RobertoD91/esp32-joystick2trainer/hardware/kicad/j2t-module-drc-report.txt

** Drc report for out/j2t-module.kicad_pcb **
** Created on 2026-11-06 23:44:49 **

** Found 73 DRC violations **
[lib_footprint_issues]: The current configuration does not include the library ''.
    Local override; Severity: warning
    @(108.3300 mm, 146.5700 mm): Footprint R7
[lib_footprint_issues]: The current configuration does not include the library ''.
    Local override; Severity: warning
    @(104.6000 mm, 151.8000 mm): Footprint J3
[lib_footprint_issues]: The current configuration does not include the library ''.
    Local override; Severity: warning
    @(109.3200 mm, 140.2000 mm): Footprint Q5
[lib_footprint_issues]: The current configuration does not include the library ''.
    Local override; Severity: warning
    @(103.4000 mm, 132.4000 mm): Footprint SW2
[lib_footprint_issues]: The current configuration does not include the library ''.
    Local override; Severity: warning
    @(104.2700 mm, 141.6400 mm): Footprint D6
[lib_footprint_issues]: The current configuration does not include the library ''.
    Local override; Severity: warning
    @(109.5300 mm, 151.0700 mm): Footprint R17
[lib_footprint_issues]: The current configuration does not include the library ''.
    Local override; Severity: warning
    @(109.1000 mm, 136.7200 mm): Footprint C7
[lib_footprint_issues]: The current configuration does not include the library ''.
    Local override; Severity: warning
    @(118.2300 mm, 138.8900 mm): Footprint R13
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
    Rule: board setup constraints silk; Severity: warning
    @(121.0000 mm, 162.0000 mm): Line on Edge.Cuts
    @(104.5900 mm, 160.4400 mm): Line on F.Silkscreen
[silk_edge_clearance]: Silkscreen clipped by board edge
    Rule: board setup constraints silk; Severity: warning
    @(121.0000 mm, 162.0000 mm): Line on Edge.Cuts
    @(117.4100 mm, 163.1000 mm): Line on F.Silkscreen
[silk_edge_clearance]: Silkscreen clipped by board edge
    Rule: board setup constraints silk; Severity: warning
    @(101.0000 mm, 100.0000 mm): Line on Edge.Cuts
    @(118.3100 mm, 100.2200 mm): Line on F.Silkscreen
[silk_edge_clearance]: Silkscreen clipped by board edge
    Rule: board setup constraints silk; Severity: warning
    @(101.0000 mm, 100.0000 mm): Line on Edge.Cuts
    @(103.6900 mm, 99.7000 mm): Line on F.Silkscreen
[silk_edge_clearance]: Silkscreen clipped by board edge
    Rule: board setup constraints silk; Severity: warning
    @(100.0000 mm, 161.0000 mm): Line on Edge.Cuts
    @(101.7500 mm, 116.3500 mm): Line on F.Silkscreen
[silk_edge_clearance]: Silkscreen clipped by board edge
    Rule: board setup constraints silk; Severity: warning
    @(100.0000 mm, 161.0000 mm): Line on Edge.Cuts
    @(101.7500 mm, 125.7500 mm): Line on F.Silkscreen

** Found 0 unconnected pads **

** Found 0 Footprint errors **

** End of Report **
