RobertoD91/esp32-joystick2trainer/hardware/images/schematic.png

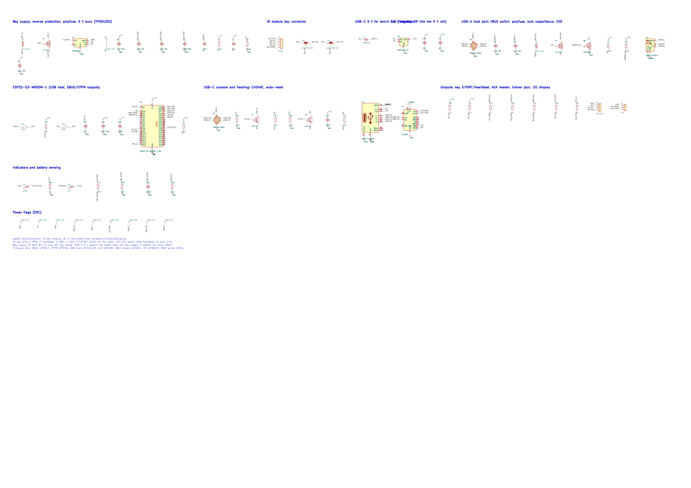
hardware/images/schematic.png
