RobertoD91/esp32-joystick2trainer/hardware/case/j2t-module-case-lite.stl

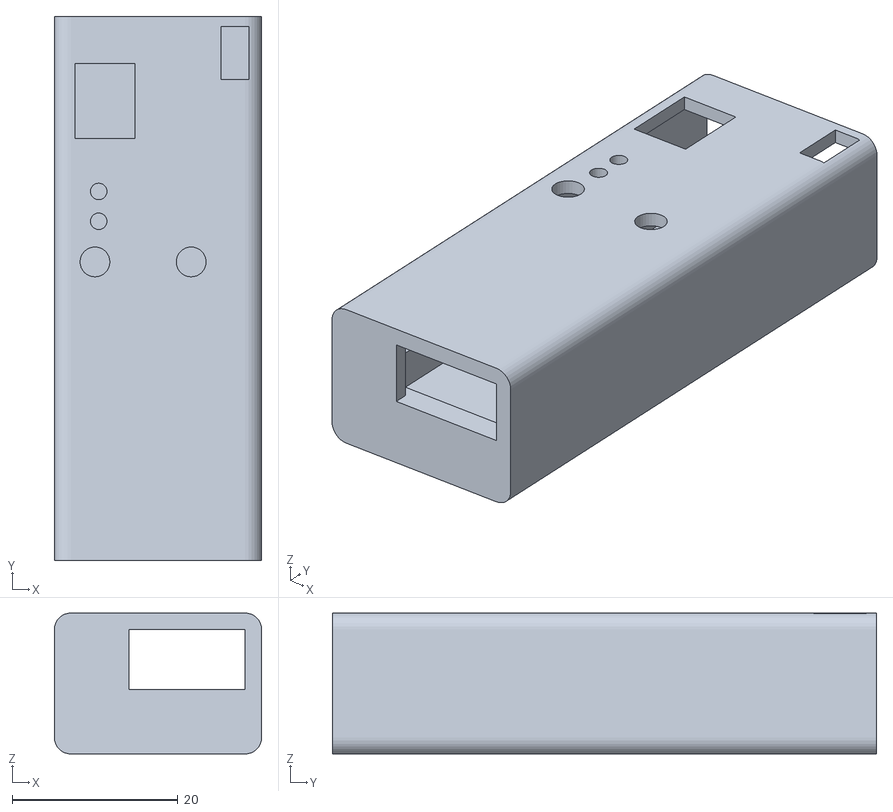
[picture p4: CAD file, 2026-11-06]
hardware/case/j2t-module-case-lite.stl
25.0 x 65.6 x 17.0
