RobertoD91/esp32-joystick2trainer/hardware/case/j2t-module-case-jr.stl

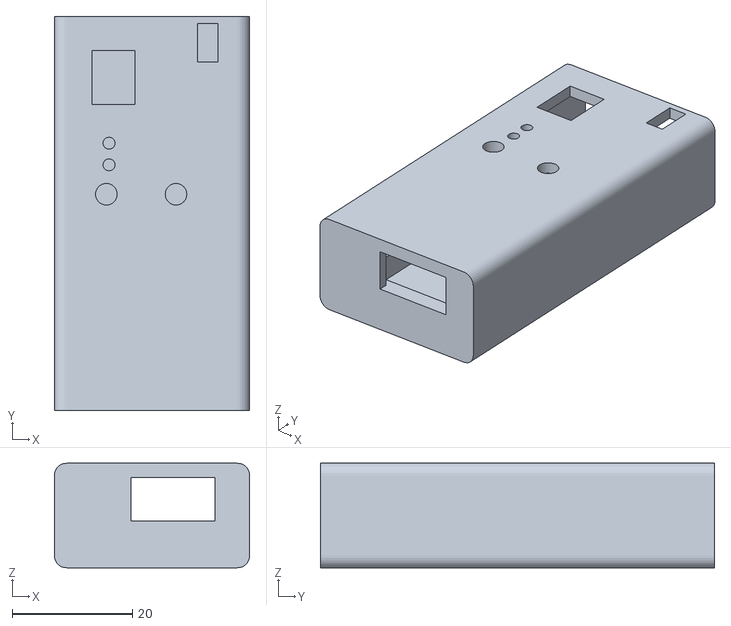
[picture p5: CAD file, 2026-11-06]
hardware/case/j2t-module-case-jr.stl
32.5 x 65.6 x 17.4
