RobertoD91/esp32-joystick2trainer/hardware/fab/j2t-module-schematic.pdf

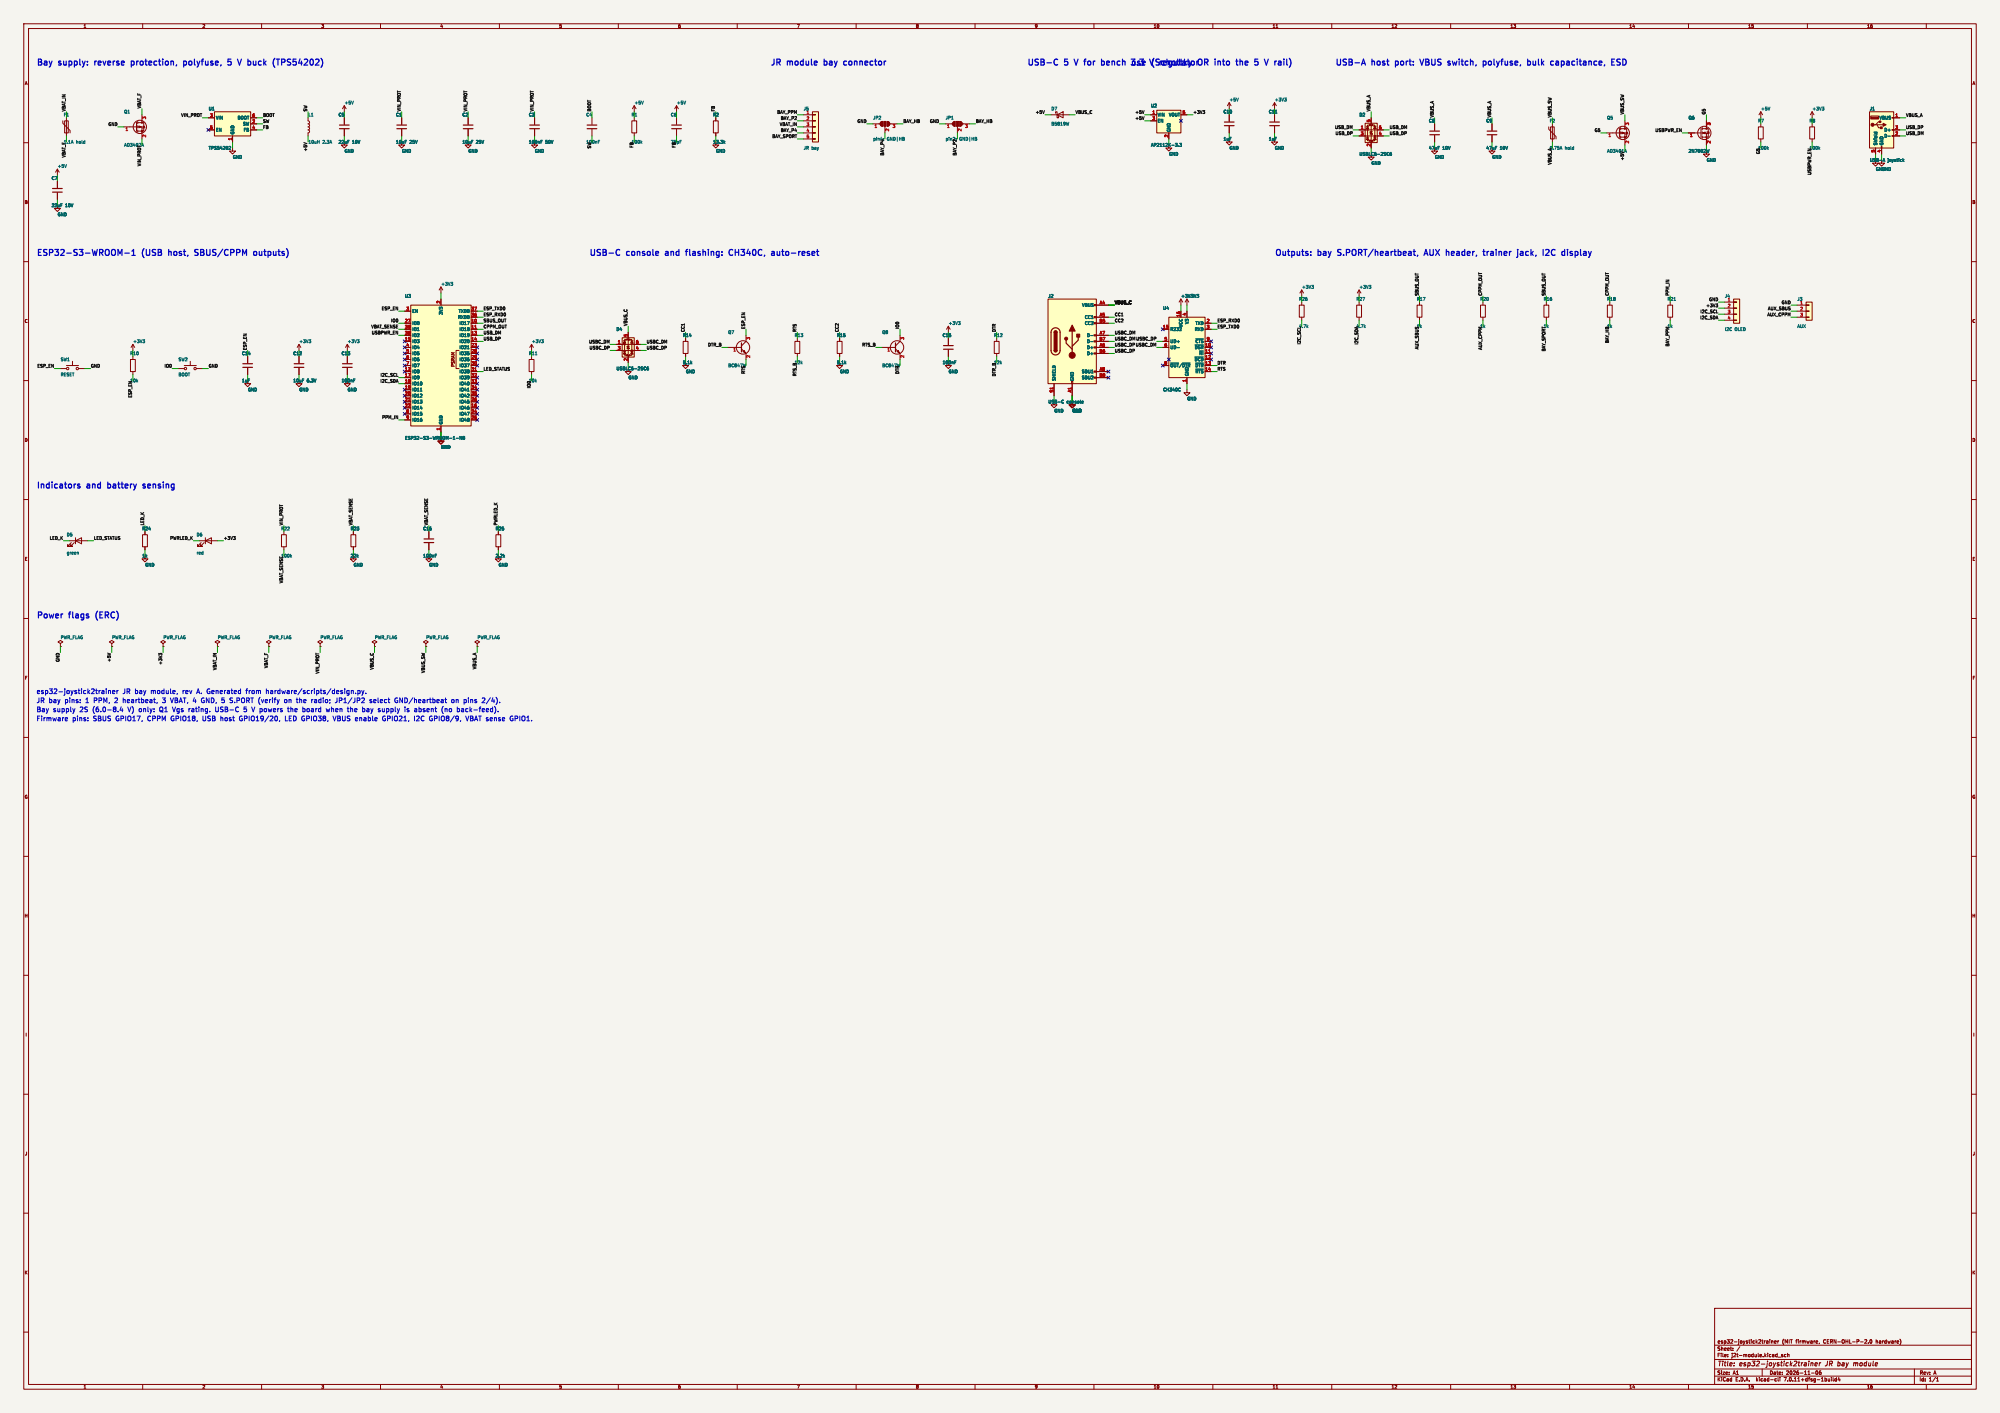
[picture p6: page 1]

JR module bay connector

1 SW 2 VIN 3 FB 4 EN 5 BOOT 6 U1 TPS54202 C4

1 SW 2 VIN 3 FB 4 EN 5 BOOT 6 GND

1 ~{DSR} 10 ~{RI} 11 ~{DCD} 12 ~{DTR} 13 ~{RTS} 14 R232

Indicators and battery sensing
