RobertoD91/esp32-joystick2trainer/hardware/fab/j2t-module-top.pdf

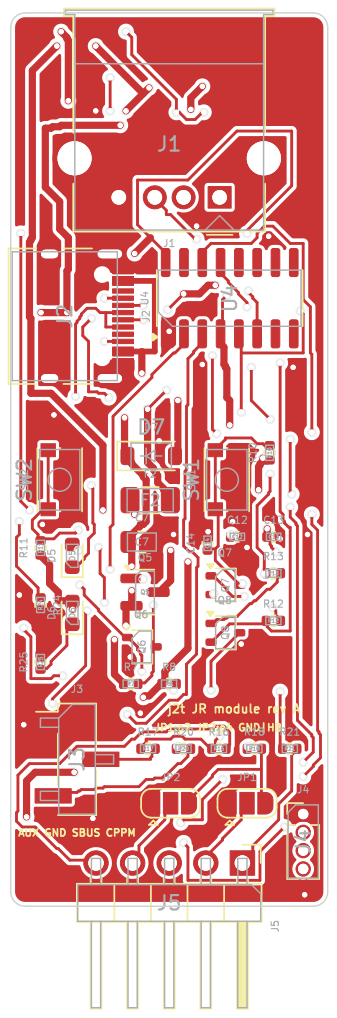
[picture p7: page 1]

AUX GND SBUS CPPM
