RobertoD91/esp32-joystick2trainer/hardware/fab/j2t-module-bottom.pdf

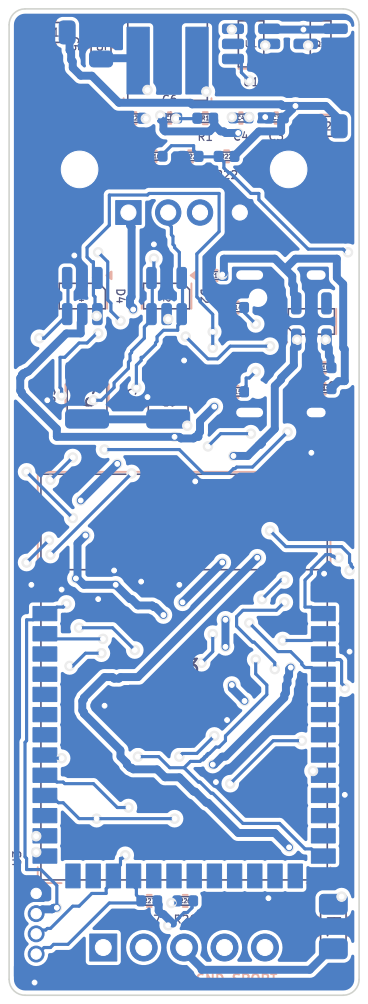
[picture p8: page 1]
