RobertoD91/esp32-joystick2trainer/hardware/kicad/j2t-module.kicad_pcb

## KiCad design hardware/kicad/j2t-module.kicad_pcb (2026-11-06)

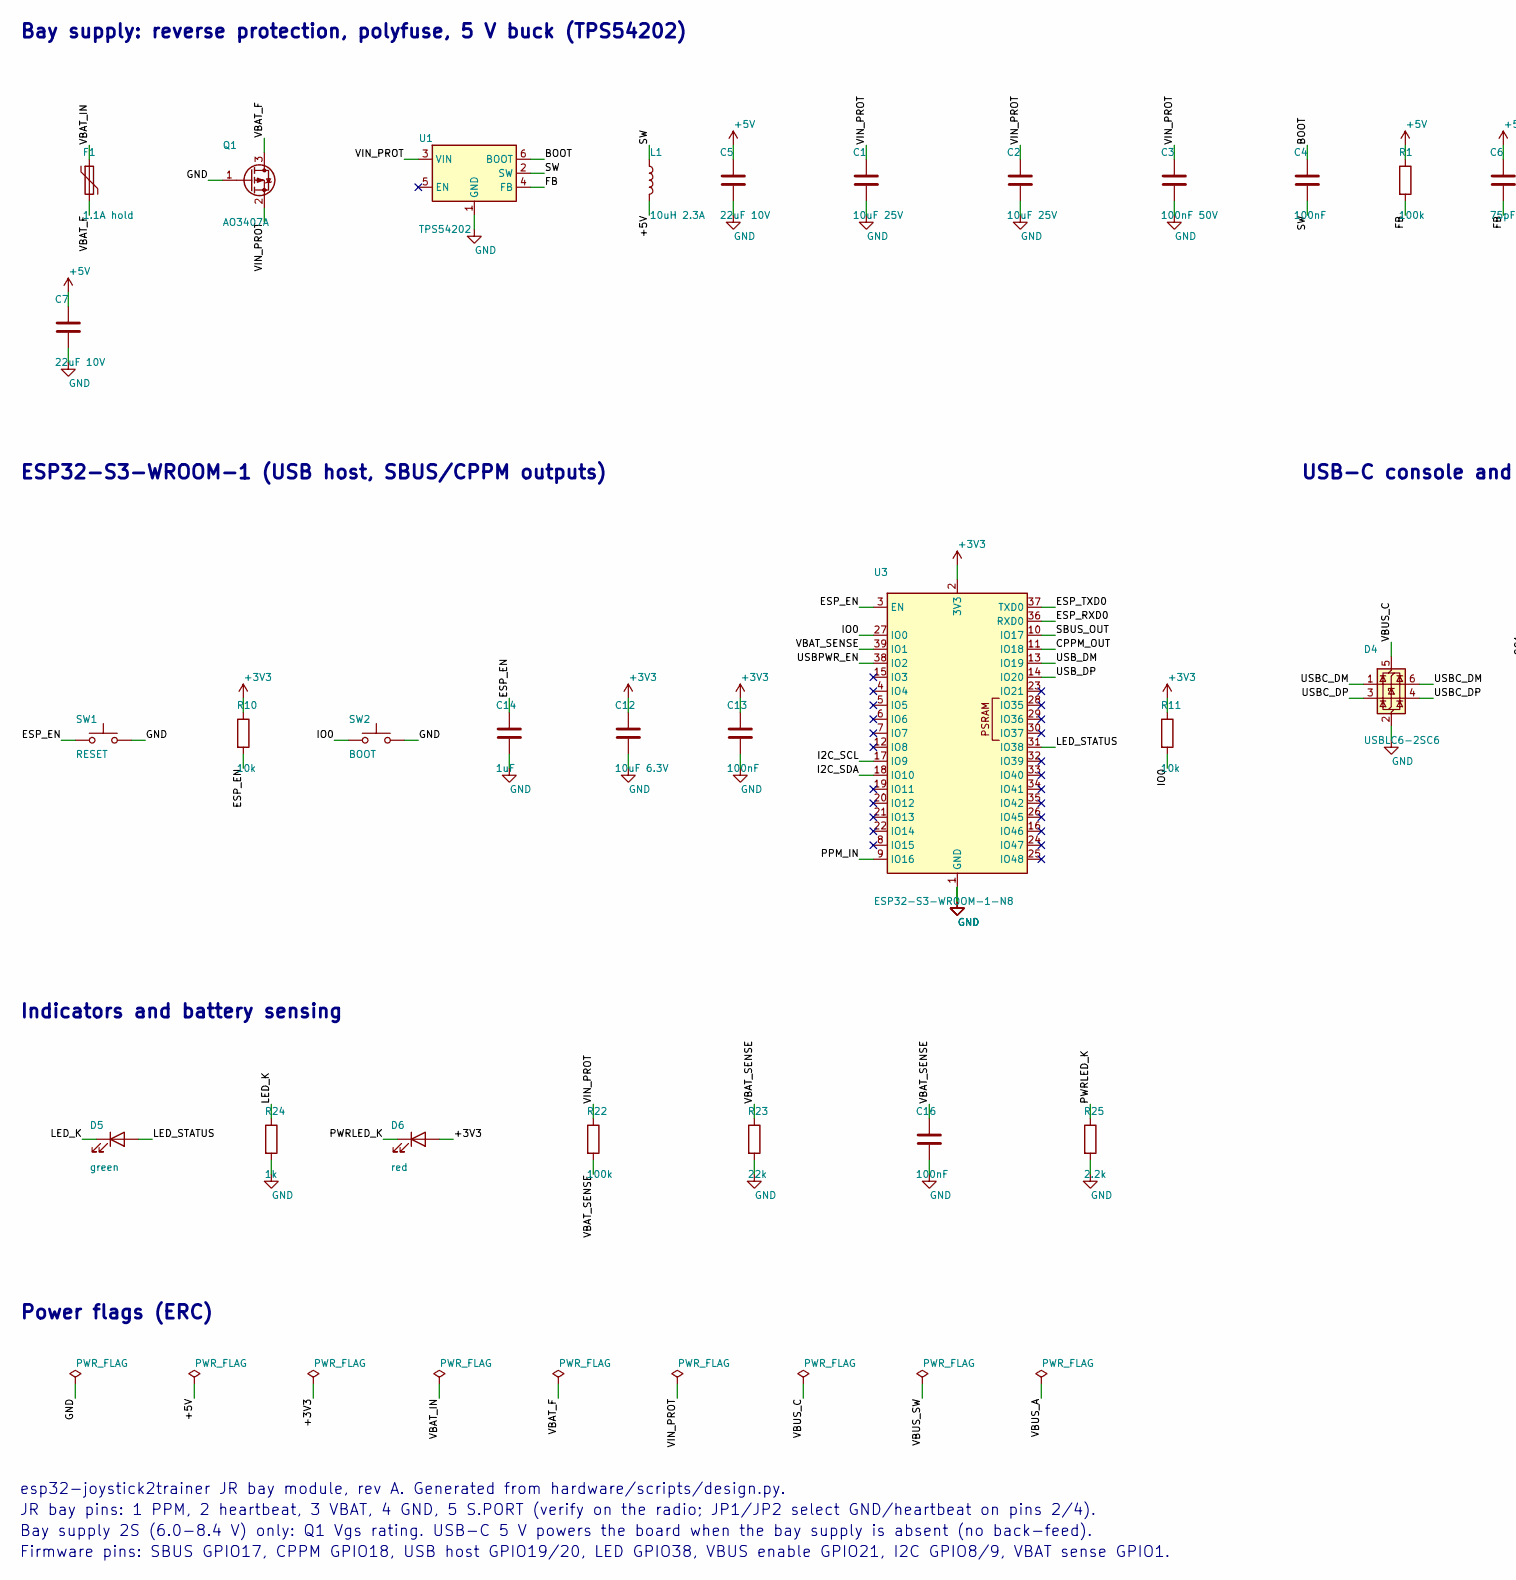
[picture p9: schematic j2t-module.kicad_sch, esp32-joystick2trainer JR bay module, part in row 1, column 1]

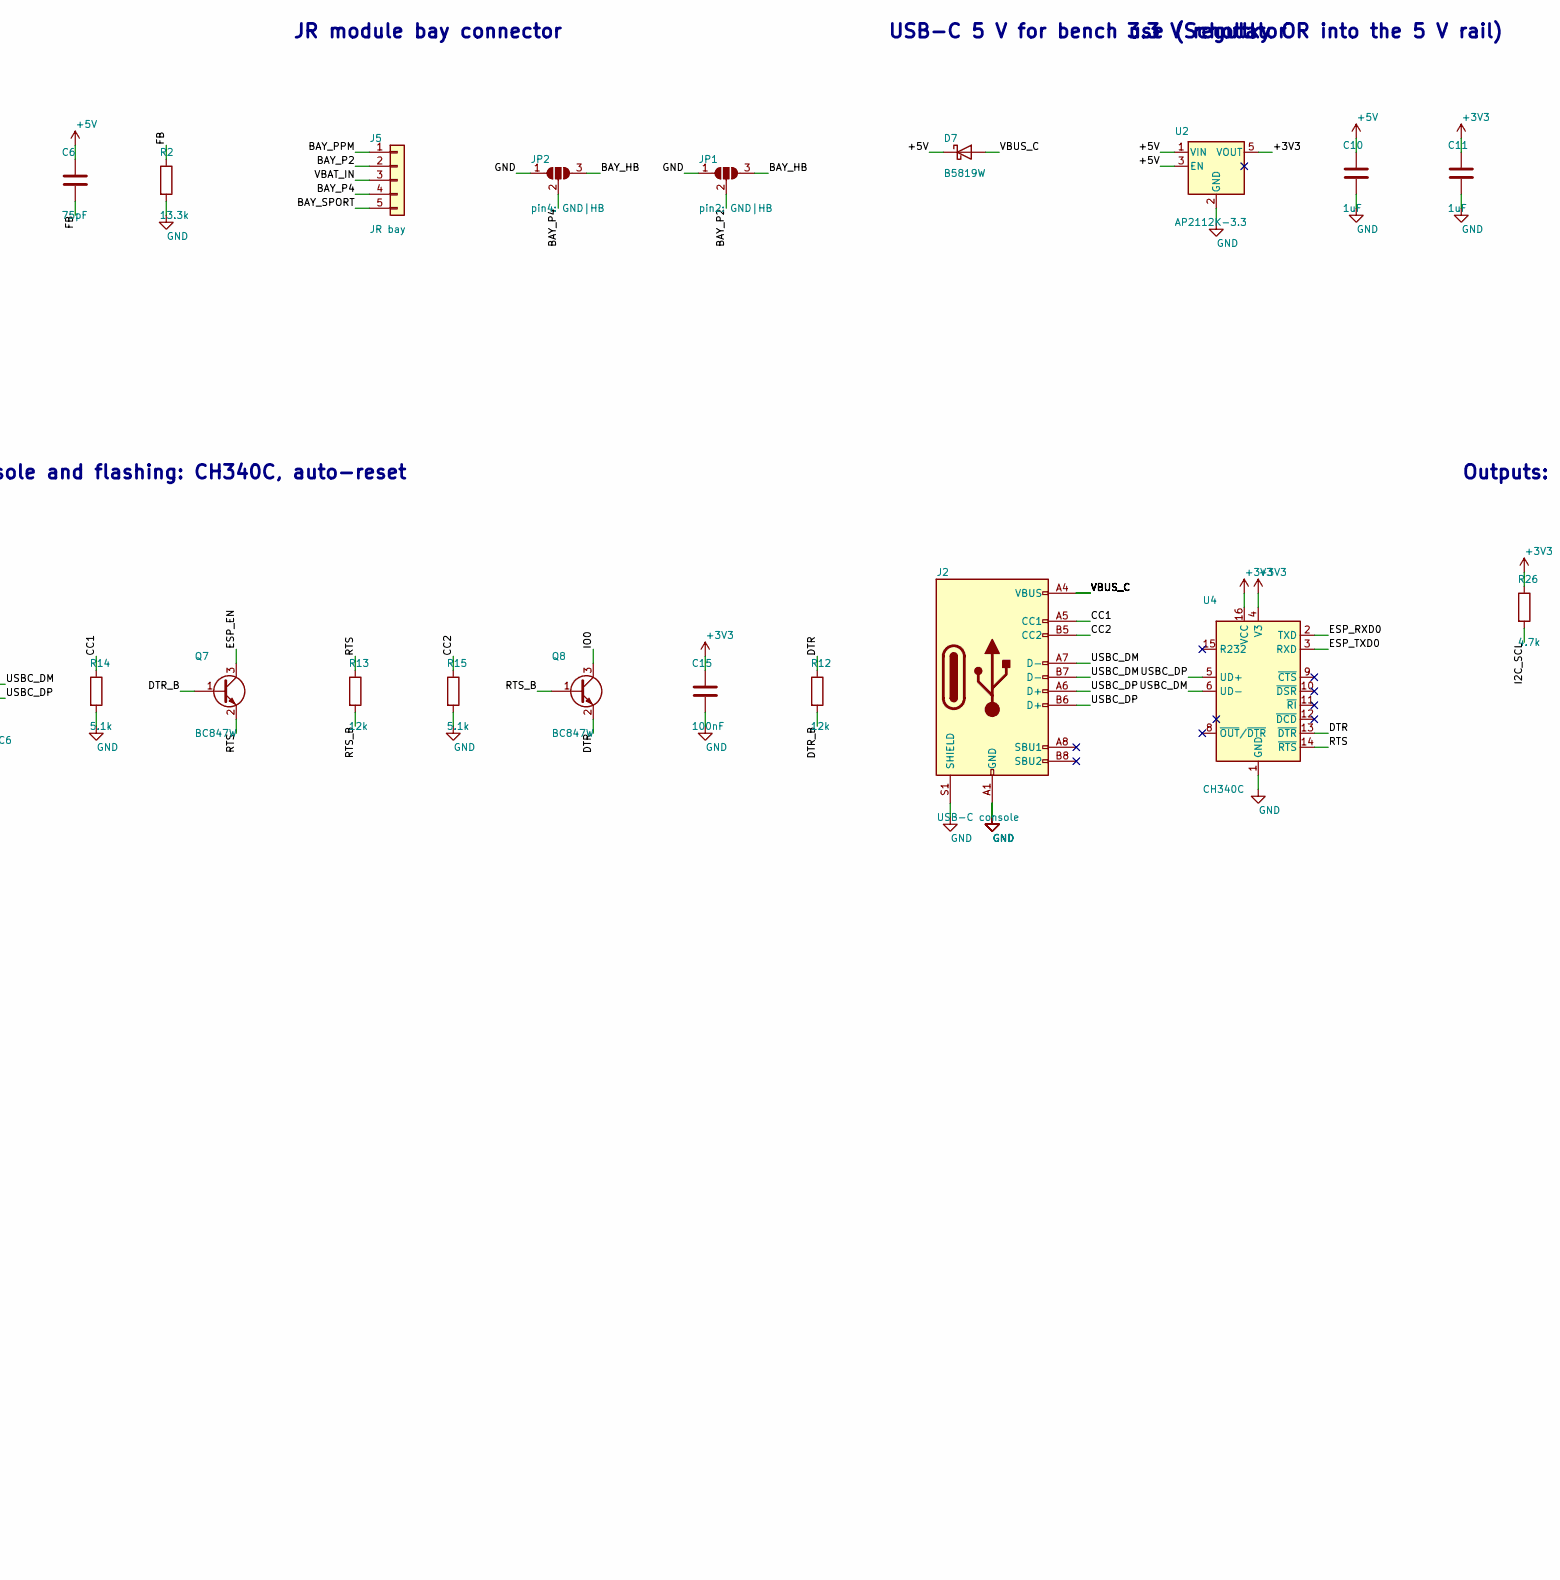
[picture p10: schematic j2t-module.kicad_sch, esp32-joystick2trainer JR bay module, part in row 1, column 2]

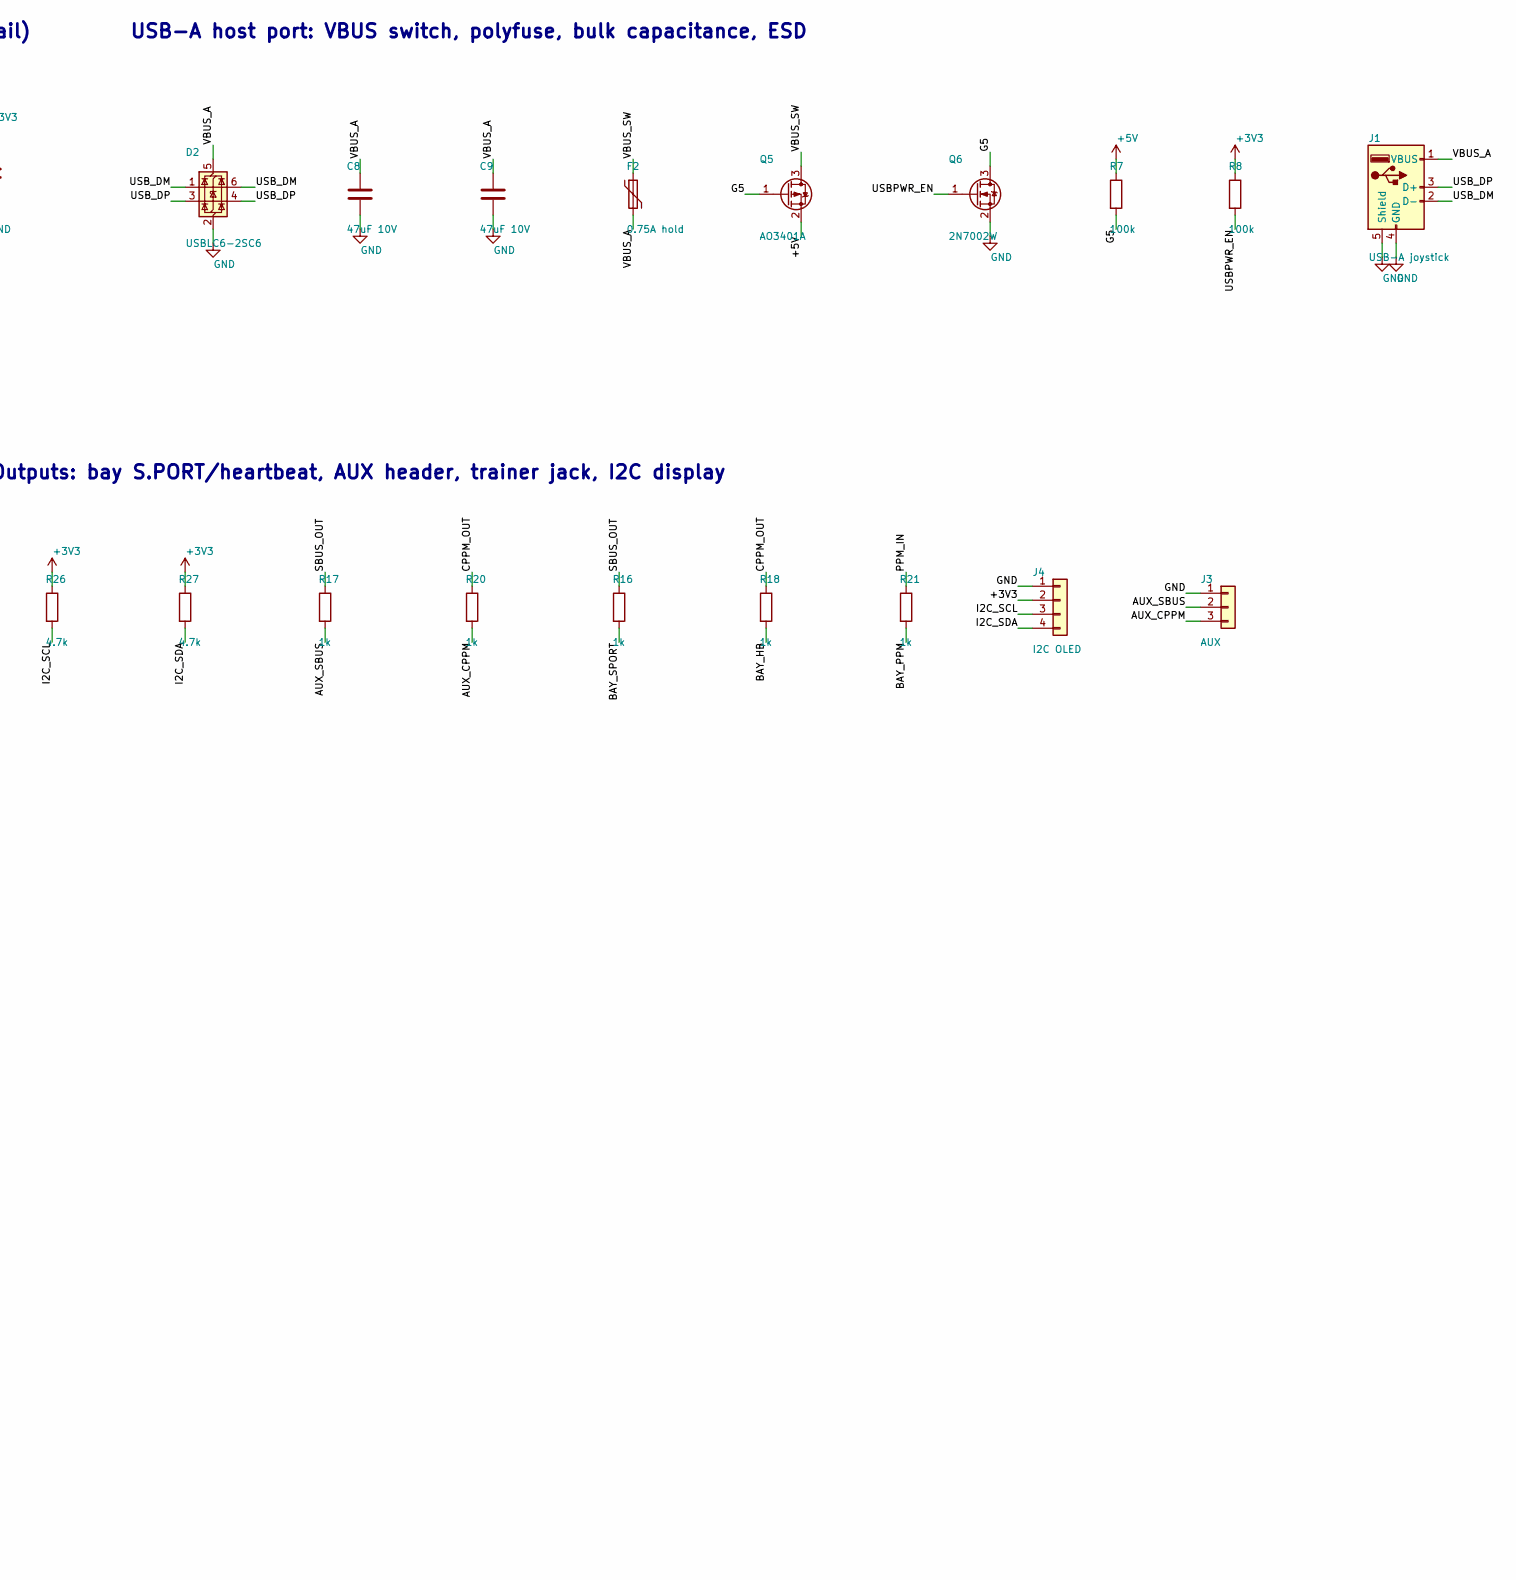
[picture p11: schematic j2t-module.kicad_sch, esp32-joystick2trainer JR bay module, part in row 1, column 3]

Parts:
C1, C2: 10uF 25V; C_0805_2012Metric
C3: 100nF 50V; C_0402_1005Metric
C4, C13, C15, C16: 100nF; C_0402_1005Metric
C5, C7: 22uF 10V; C_0805_2012Metric
C6: 75pF; C_0402_1005Metric
C8, C9: 47uF 10V; C_1210_3225Metric
C10, C11, C14: 1uF; C_0402_1005Metric
C12: 10uF 6.3V; C_0402_1005Metric
D2, D4: USBLC6-2SC6; SOT-23-6; MPN USBLC6-2SC6
D5: green; LED_0603_1608Metric
D6: red; LED_0603_1608Metric
D7: B5819W; D_SOD-123; MPN B5819W
F1: 1.1A hold; Fuse_1206_3216Metric; MPN 1206L110
F2: 0.75A hold; Fuse_1206_3216Metric; MPN 1206L075
J1: USB-A joystick; USB_A_Molex_67643_Horizontal; MPN Molex 67643-0910 or equivalent right-an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
J2: USB-C console; USB_C_Receptacle_HRO_TYPE-C-31-M-12; MPN HRO TYPE-C-31-M-12
J3: AUX; PinHeader_1x03_P2.54mm_Vertical_SMD_Pin1Left
J4: I2C OLED; PinHeader_1x04_P1.27mm_Vertical; MPN 1.27 mm pitch 1x4 pin header (or solder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
J5: JR bay; PinHeader_1x05_P2.54mm_Horizontal; MPN 2.54 mm right-angle header, long pins
JP1: pin2: GND|HB; SolderJumper-3_P1.3mm_Open_RoundedPad1.0x1.5mm
JP2: pin4: GND|HB; SolderJumper-3_P1.3mm_Open_RoundedPad1.0x1.5mm
L1: 10uH 2.3A; L_Sunlord_SWPA5040S; MPN SWPA5040S100MT
Q1: AO3407A; SOT-23; MPN AO3407A
Q5: AO3401A; SOT-23; MPN AO3401A
Q6: 2N7002W; SOT-323_SC-70; MPN 2N7002W
Q7, Q8: BC847W; SOT-323_SC-70; MPN BC847W
R1, R7, R8, R22: 100k; R_0402_1005Metric
R2: 13.3k; R_0402_1005Metric
R10, R11: 10k; R_0402_1005Metric
R12, R13: 12k; R_0402_1005Metric
R14, R15: 5.1k; R_0402_1005Metric
R16, R17, R18, R20, R21, R24: 1k; R_0402_1005Metric
R23: 22k; R_0402_1005Metric
R25: 2.2k; R_0402_1005Metric
R26, R27: 4.7k; R_0402_1005Metric
SW1: RESET; SW_Push_1P1T_NO_CK_KMR2; MPN KMR221GLFS
SW2: BOOT; SW_Push_1P1T_NO_CK_KMR2; MPN KMR221GLFS
U1: TPS54202; SOT-23-6; MPN TPS54202DDCR
U2: AP2112K-3.3; SOT-23-5; MPN AP2112K-3.3TRG1
U3: ESP32-S3-WROOM-1-N8; ESP32-S3-WROOM-1; MPN ESP32-S3-WROOM-1-N8
U4: CH340C; SOIC-16_3.9x9.9mm_P1.27mm; MPN CH340C

Connections:
AUX_CPPM: J3.3, R20.2
AUX_SBUS: J3.2, R17.2
BAY_HB: JP1.3 (B), JP2.3 (B), R18.2
BAY_P2: J5.2, JP1.2 (C)
BAY_P4: J5.4, JP2.2 (C)
BAY_PPM: J5.1, R21.2
BAY_SPORT: J5.5, R16.2
BOOT: C4.1, U1.6 (BOOT)
CC1: J2.A5 (CC1), R14.1
CC2: J2.B5 (CC2), R15.1
CPPM_OUT: R18.1, R20.1, U3.11 (IO18)
DTR: Q8.2 (E), R12.1, U4.13 (~DTR)
DTR_B: Q7.1 (B), R12.2
ESP_EN: C14.1, Q7.3 (C), R10.2, SW1.1, U3.3 (EN)
ESP_RXD0: U3.36 (RXD0), U4.2 (TXD)
ESP_TXD0: U3.37 (TXD0), U4.3 (RXD)
FB: C6.2, R1.2, R2.1, U1.4 (FB)
G5: Q5.1 (G), Q6.3 (D), R7.2
I2C_SCL: J4.3, R26.2, U3.17 (IO9)
I2C_SDA: J4.4, R27.2, U3.18 (IO10)
IO0: Q8.3 (C), R11.2, SW2.1, U3.27 (IO0)
LED_K: D5.1 (K), R24.1
LED_STATUS: D5.2 (A), U3.31 (IO38)
PPM_IN: R21.1, U3.9 (IO16)
PWRLED_K: D6.1 (K), R25.1
RTS: Q7.2 (E), R13.1, U4.14 (~RTS)
RTS_B: Q8.1 (B), R13.2
SBUS_OUT: R16.1, R17.1, U3.10 (IO17)
SW: C4.2, L1.1, U1.2 (SW)
USBC_DM: D4.1 (I/O1), D4.6 (I/O1), J2.A7 (D-), J2.B7 (D-), U4.6 (UD-)
USBC_DP: D4.3 (I/O2), D4.4 (I/O2), J2.A6 (D+), J2.B6 (D+), U4.5 (UD+)
USBPWR_EN: Q6.1 (G), R8.2, U3.38 (IO2)
USB_DM: D2.1 (I/O1), D2.6 (I/O1), J1.2 (D-), U3.13 (IO19)
USB_DP: D2.3 (I/O2), D2.4 (I/O2), J1.3 (D+), U3.14 (IO20)
VBAT_SENSE: C16.1, R22.2, R23.1, U3.39 (IO1)

Notes on the sheet:
Bay supply: reverse protection, polyfuse, 5 V buck (TPS54202)
JR module bay connector
USB-C 5 V for bench use (Schottky OR into the 5 V rail)
3.3 V regulator
USB-A host port: VBUS switch, polyfuse, bulk capacitance, ESD
ESP32-S3-WROOM-1 (USB host, SBUS/CPPM outputs)
USB-C console and flashing: CH340C, auto-reset
Outputs: bay S.PORT/heartbeat, AUX header, trainer jack, I2C display
Indicators and battery sensing
Power flags (ERC)
esp32-joystick2trainer JR bay module, rev A. Generated from hardware/scripts/design.py.
JR bay pins: 1 PPM, 2 heartbeat, 3 VBAT, 4 GND, 5 S.PORT (verify on the radio; JP1/JP2 select GND/heartbeat on pins 2/4).
Bay supply 2S (6.0-8.4 V) only: Q1 Vgs rating. USB-C 5 V powers the board when the bay supply is absent (no back-feed).
Firmware pins: SBUS GPIO17, CPPM GPIO18, USB host GPIO19/20, LED GPIO38, VBUS enable GPIO21, I2C GPIO8/9, VBAT sense GPIO1.

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
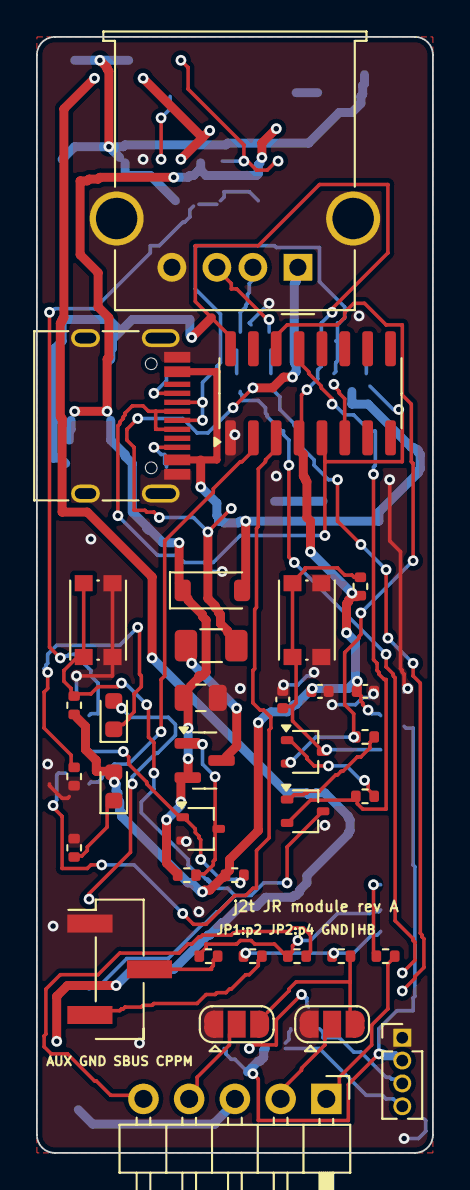
[picture p12: board j2t-module.kicad_pcb from above]

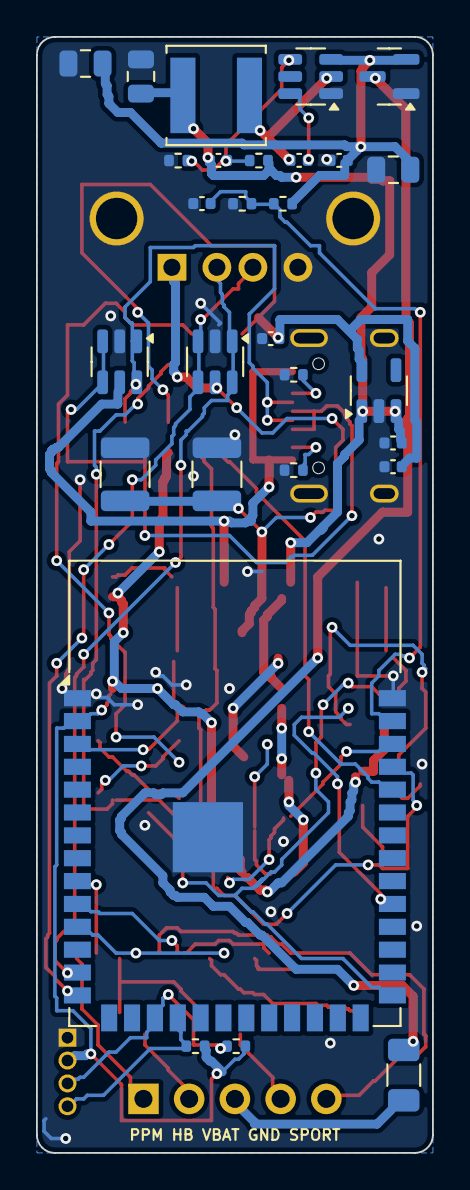
[picture p13: board j2t-module.kicad_pcb from below]

Board: 2 copper layers, 22.0 x 62.0 mm, 63 parts (28 on the bottom side), 44 nets.
