RobertoD91/esp32-joystick2trainer/src/app/config_store.cpp

// SPDX-License-Identifier: MIT
#include "app/config_store.hpp"

#include <cstddef>
#include <cstring>

#include "esp_log.h"
#include "nvs.h"
#include "nvs_flash.h"

namespace app {

namespace {
const char* TAG = "config";
constexpr const char* kNamespace = "j2t";
constexpr const char* kKey = "cfg";

class Lock {
public:
    explicit Lock(SemaphoreHandle_t m) : m_(m) { xSemaphoreTake(m_, portMAX_DELAY); }
    ~Lock() { xSemaphoreGive(m_); }
    Lock(const Lock&) = delete;
    Lock& operator=(const Lock&) = delete;

private:
    SemaphoreHandle_t m_;
};
}  // namespace

ConfigStore::ConfigStore() {
    mutex_ = xSemaphoreCreateMutex();
}

void ConfigStore::init() {
    esp_err_t err = nvs_flash_init();
    if (err == ESP_ERR_NVS_NO_FREE_PAGES || err == ESP_ERR_NVS_NEW_VERSION_FOUND) {
        ESP_LOGW(TAG, "NVS partition needs erasing (%s)", esp_err_to_name(err));
        ESP_ERROR_CHECK(nvs_flash_erase());
        err = nvs_flash_init();
    }
    ESP_ERROR_CHECK(err);

    rc::Config stored;
    if (readBlob(stored)) {
        Lock lock(mutex_);
        config_ = stored;
        loaded_from_nvs_ = true;
        ESP_LOGI(TAG, "configuration loaded from NVS");
    } else {
        ESP_LOGI(TAG, "using factory defaults (nothing valid stored)");
    }
}

namespace {

/// Older blob layouts that can be migrated by copying their leading bytes over the defaults:
/// every version so far only appended fields at the end of rc::Config (or of its last member
/// FfbConfig). `prefix` is the number of meaningful bytes, `size` the stored blob size (the
/// prefix rounded up to the struct alignment, i.e. the old sizeof).
struct LegacyLayout {
    uint32_t version;
    std::size_t prefix;
    std::size_t size;
};

constexpr std::size_t roundUp(std::size_t n) {
    return (n + alignof(rc::Config) - 1) / alignof(rc::Config) * alignof(rc::Config);
}

static_assert(offsetof(rc::Config, ffb) + sizeof(rc::FfbConfig) <= sizeof(rc::Config),
              "FfbConfig must stay the last member of rc::Config");
static_assert(offsetof(rc::FfbConfig, direction_form) == 4, "FfbConfig layout changed: update kLegacyLayouts");

constexpr LegacyLayout kLegacyLayouts[] = {
    // Version 3 (0.9.0): no FfbConfig at all.
    {3, offsetof(rc::Config, ffb), roundUp(offsetof(rc::Config, ffb))},
    // Version 4: FfbConfig without `direction_form` (enabled, spring, gain, deadband).
    {4, offsetof(rc::Config, ffb) + 4, roundUp(offsetof(rc::Config, ffb) + 4)},
};

}  // namespace

bool ConfigStore::readBlob(rc::Config& out) {
    nvs_handle_t handle;
    if (nvs_open(kNamespace, NVS_READONLY, &handle) != ESP_OK) {
        return false;
    }

    size_t size = 0;
    esp_err_t err = nvs_get_blob(handle, kKey, nullptr, &size);
    bool ok = false;
    if (err == ESP_OK && size > sizeof(uint32_t) && size <= sizeof(rc::Config)) {
        alignas(rc::Config) uint8_t raw[sizeof(rc::Config)] = {0};
        err = nvs_get_blob(handle, kKey, raw, &size);
        uint32_t version = 0;
        std::memcpy(&version, raw, sizeof(version));
        const LegacyLayout* legacy = nullptr;
        for (const LegacyLayout& l : kLegacyLayouts) {
            if (l.version == version && l.size == size) {
                legacy = &l;
            }
        }
        if (err == ESP_OK && size == sizeof(rc::Config) && version == rc::kConfigVersion) {
            std::memcpy(&out, raw, sizeof(out));
            ok = true;
        } else if (err == ESP_OK && legacy != nullptr) {
            // Keep every setting the old firmware knew, take the defaults for the new fields.
            rc::Config migrated = rc::defaultConfig();
            std::memcpy(&migrated, raw, legacy->prefix);
            migrated.version = rc::kConfigVersion;
            out = migrated;
            ok = true;
            ESP_LOGW(TAG, "stored configuration migrated from version %lu to %lu (new keys at their defaults)",
                     static_cast<unsigned long>(version), static_cast<unsigned long>(rc::kConfigVersion));
        } else if (err == ESP_OK) {
            ESP_LOGW(TAG, "stored configuration ignored (version %lu, %u bytes; expected %lu, %u bytes)",
                     static_cast<unsigned long>(version), static_cast<unsigned>(size),
                     static_cast<unsigned long>(rc::kConfigVersion), static_cast<unsigned>(sizeof(rc::Config)));
        }
    } else if (err == ESP_OK) {
        ESP_LOGW(TAG, "stored configuration has the wrong size (%u vs %u)", static_cast<unsigned>(size),
                 static_cast<unsigned>(sizeof(rc::Config)));
    }
    nvs_close(handle);
    return ok;
}

rc::Config ConfigStore::get() const {
    Lock lock(mutex_);
    return config_;
}

void ConfigStore::set(const rc::Config& cfg) {
    Lock lock(mutex_);
    config_ = cfg;
    config_.version = rc::kConfigVersion;
}

void ConfigStore::copyMapping(rc::MappingConfig& mapping, bool& log_input) const {
    Lock lock(mutex_);
    mapping = config_.mapping;
    log_input = config_.log_input;
}

void ConfigStore::copyFailsafe(rc::FailsafeMode& mode, uint32_t& timeout_ms, rc::MappingConfig& mapping) const {
    Lock lock(mutex_);
    mode = config_.failsafe;
    timeout_ms = config_.input_timeout_ms;
    mapping = config_.mapping;
}

void ConfigStore::copySbus(rc::SbusConfig& sbus) const {
    Lock lock(mutex_);
    sbus = config_.sbus;
}

void ConfigStore::copyCppm(rc::CppmConfig& cppm) const {
    Lock lock(mutex_);
    cppm = config_.cppm;
}

bool ConfigStore::save() {
    const rc::Config snapshot = get();
    nvs_handle_t handle;
    esp_err_t err = nvs_open(kNamespace, NVS_READWRITE, &handle);
    if (err != ESP_OK) {
        ESP_LOGE(TAG, "nvs_open failed: %s", esp_err_to_name(err));
        return false;
    }
    err = nvs_set_blob(handle, kKey, &snapshot, sizeof(snapshot));
    if (err == ESP_OK) {
        err = nvs_commit(handle);
    }
    nvs_close(handle);
    if (err != ESP_OK) {
        ESP_LOGE(TAG, "saving failed: %s", esp_err_to_name(err));
        return false;
    }
    loaded_from_nvs_ = true;
    return true;
}

bool ConfigStore::load() {
    rc::Config stored;
    if (!readBlob(stored)) {
        return false;
    }
    set(stored);
    return true;
}

void ConfigStore::resetToDefaults() {
    set(rc::defaultConfig());
    nvs_handle_t handle;
    if (nvs_open(kNamespace, NVS_READWRITE, &handle) == ESP_OK) {
        nvs_erase_key(handle, kKey);
        nvs_commit(handle);
        nvs_close(handle);
    }
    loaded_from_nvs_ = false;
}

}  // namespace app
