RobertoD91/esp32-joystick2trainer/src/app/console.hpp

// SPDX-License-Identifier: MIT
// Serial console (UART0) for configuration and diagnostics.
#pragma once

namespace app {

class ConfigStore;
class InputHub;
class UsbJoystick;
class SbusOutput;
class CppmOutput;
class FfbController;

struct ConsoleContext {
    ConfigStore* config;
    InputHub* hub;
    UsbJoystick* usb;
    SbusOutput* sbus;
    CppmOutput* cppm;
    FfbController* ffb;
};

/// Register the commands and start the REPL task. `ctx` must outlive the program.
void startConsole(ConsoleContext* ctx);

}  // namespace app
