RobertoD91/esp32-joystick2trainer/(commit log)

2026-09-20 USB HID joystick to SBUS/CPPM trainer bridge for ESP32-S3
    PlatformIO/ESP-IDF 6.x firmware that reads a wired USB HID joystick through
    the ESP32-S3 native USB host and emits SBUS (UART, hardware inverted) and
    CPPM (RMT peripheral) simultaneously for EdgeTX trainer inputs.
    - lib/rc_core: SBUS and CPPM encoders, RMT symbol packer, channel mapper,
    configuration model with key/value interface (hardware independent)
    - lib/hid_core: allocation-free HID report descriptor parser and joystick
    decoder, verified against the SideWinder Force Feedback 2 descriptor
    - src/app: USB host + usb_host_hid integration with hot-plug handling,
    SBUS/CPPM output tasks, NVS persistence, esp_console configuratio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
    [config_store.cpp, config_store.hpp, console.cpp, console.hpp, cppm_output.cpp, input_hub.cpp]
2026-09-20 Docs: the DevKitC-1 cannot power a USB device on its native port
    The board schematic routes the native USB connector's VBUS through diode D7
    towards the 5 V rail only; there are no OTG power pads. Document the three
    ways to supply VBUS (powered OTG Y-cable, 5V-to-VBUS wire or D7 bridge,
    USB-A breakout on the header) and drop the wrong solder-pad advice.
    Claude-Session: https://claude.ai/code/session_015DBs9P1aSS3HKtBFFt9nvn
2026-09-20 Release 0.9.0: document the verified SBUS-on-AUX setup, add changelog and release job
    README records the first hardware bring-up (SideWinder FFB2 + DevKitC-1 +
    TX16S MKII over the AUX serial port with sbus.inverted 0) and marks the CPPM
    jack and S.PORT paths as not yet tested. CI now turns a pushed v* tag into a
    GitHub release with the firmware binaries and checksums attached.
    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
2026-09-20 CI: allow creating a release from a manual workflow run
    The release job now also runs on workflow_dispatch with release_version set;
    it creates the vX.Y.Z tag on the current commit and publishes the release.
    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
2026-10-24 Add PID force feedback (centring spring) and record the first flight
    - hid_core: descriptor parser now covers OUTPUT/FEATURE fields, array usage
    lists, collections and HID units; bit-field codec; generic PID client
    (device control/gain, create effect + block load, set effect/condition/
    periodic, effect operation, state report) verified against the SideWinder
    FFB2 descriptor in 16 new host tests.
    - components/usb_host_hid: vendored Espressif driver 1.2.1 with an interrupt
    OUT endpoint API for output reports (NOTICE.md documents the change); the
    usb host library stays a registry dependency.
    - app: FfbController task creates and runs the spring on connection, applies
    ffb.* changes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
2026-10-25 Fix force feedback transport recovery, add ffb.direction and device support notes
    Vendored HID driver:
    - Recover the interrupt OUT endpoint after a failed output report: cancel a
    timed-out transfer (halt/flush), send CLEAR_FEATURE(ENDPOINT_HALT) after a
    STALL and clear the pipe, instead of leaving it unusable until re-plug.
    - Submit output reports under the driver's open/close mutex so that a
    concurrent disconnect cannot free the interface or its transfer mid-call.
    - Quiesce the OUT endpoint when an interface is stopped or closed.
    - Release the two OUT semaphores on the install failure path.
    Force feedback:
    - Fall back to control-pipe SET_REPORT when the OUT endpoint fails.
    - Upload t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
    [config_store.cpp, console.cpp, ffb.cpp, ffb.hpp, test_config_kv.cpp]
2026-10-25 Docs: hardware options (other microcontrollers, I2C display)
    Records the evaluation of ESP32-S2/P4/C3/C5, RP2040/RP2350 and of an I2C
    status display: only the ESP32-S2 is a cheap second target, the RP2040
    family would be a second port, the C series has no USB host. Linked from
    the README bill of materials and roadmap.
    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
2026-11-06 Hardware: JR bay module prototype PCB
    Add hardware/: a 22 x 62 mm two-layer board for the radio's module bay with an
    ESP32-S3-WROOM-1, USB-A host port with switched and fused VBUS, USB-C console
    (CH340C, auto-reset), 2S buck converter (TPS54202), SBUS/CPPM on the bay pins with
    solder jumpers for the heartbeat/GND order, an AUX header and I2C display pins.
    The KiCad 7 project is generated from hardware/scripts/design.py: schematic with a
    netlist check, PCB placement by regions, a grid router with rip-up and re-route,
    ground pours with island stitching, DRC. Delivered with Gerbers, drill files,
    pick-and-place, BOM, PDFs, DRC report, a parametric OpenSCAD case (standard JR and
    lite variants) a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
    [case.scad, j2t-module-bom.csv, j2t-module-case-jr.stl, j2t-module-case-lite.stl, j2t-module.kicad_pcb, j2t-module.kicad_sch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]
